YusufOck/TRAFFIC-LIGHT-CONTROL-WITH-SENSOR/(list of files, drawings)

Other design files:
Traffic_Light_Controller_Module_Project/DSD Traffic Module - last knight.pdsprj
Traffic_Light_Controller_Module_Project/Microprocessor_Circuit_Proteus.pdsprj
