YusufOck/TRAFFIC-LIGHT-CONTROL-WITH-SENSOR/(commit log)

2025-06-12 TRAFFIC LIGHT CONTROL WITH SENSOR
    TRAFFIC LIGHT CONTROL WITH SENSOR
    [DSD Traffic Module - last knight.pdsprj, Microprocessor_Circuit_Proteus.pdsprj]
2025-06-12 PCB
    PCB and BREADBOARD implementation
